Vladandrei23/STR/README.md

# STR
Smart Transport Robot

Link proiect 3D robot: https://cad.onshape.com/documents/0fa316edc2ccdc5bc86daad0/w/06460c8543eb481df427b248/e/61f51f2530e62bfbe1d57860

Link video demonstrativ: https://www.youtube.com/watch?v=n41Xtc9-K9c
