Vladandrei23/STR/poster STR.png

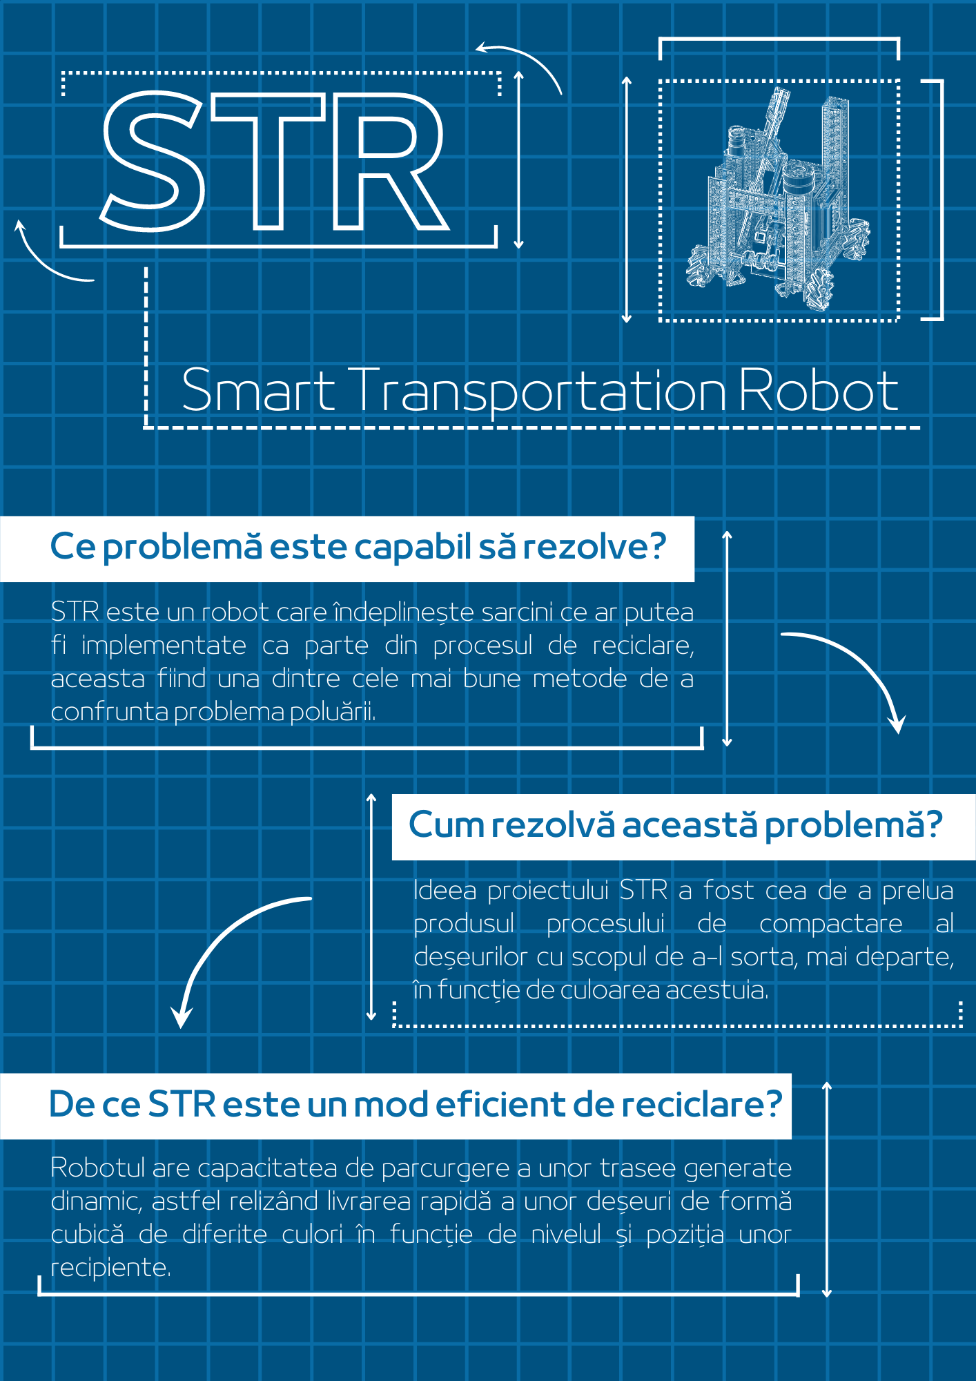
poster STR.png
