Vladandrei23/STR/piese printate 3d/brat.step

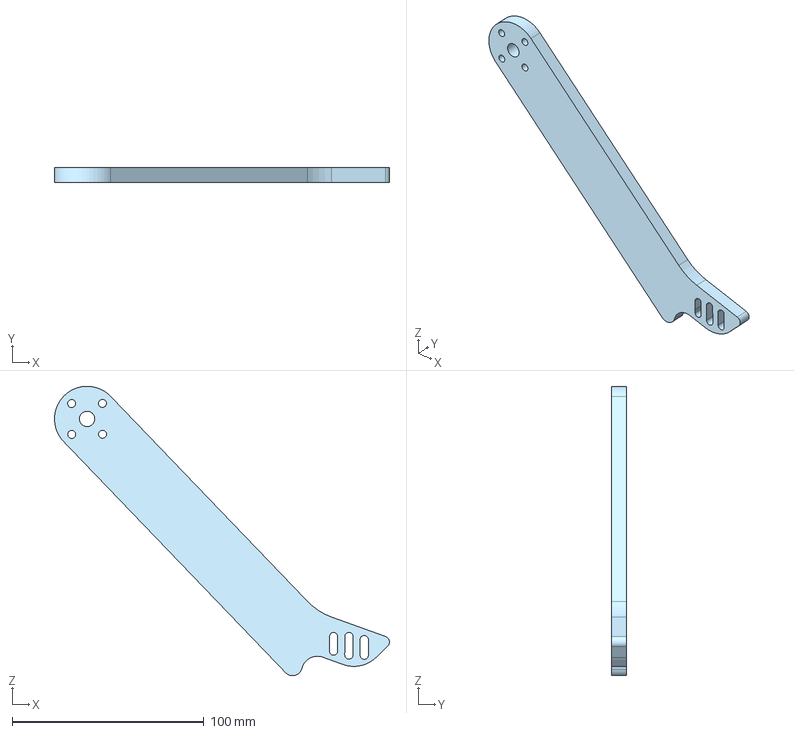
[picture p3: CAD file, 2022-07-07]
piese printate 3d/brat.step
174.6 x 8.00 x 150.8 mm
