Vladandrei23/STR/piese printate 3d/piese intake.step

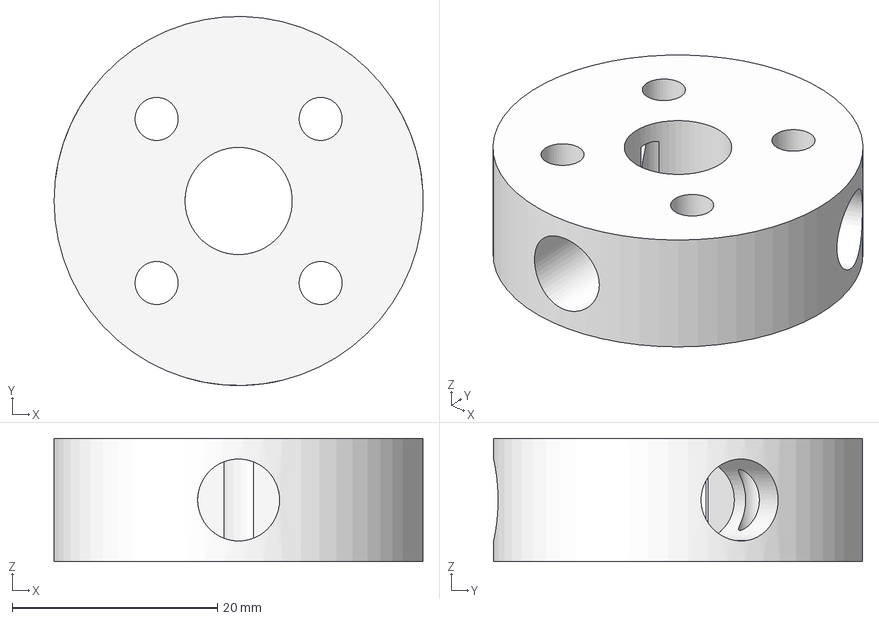
[picture p4: CAD file, 2022-07-07]
piese printate 3d/piese intake.step
36.0 x 36.0 x 12.0 mm
