Vladandrei23/STR/piese printate 3d/cutie.step

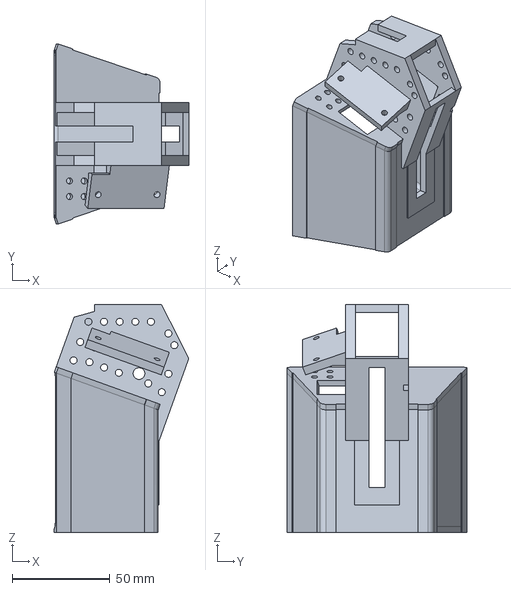
[picture p5: CAD file, 2022-07-07]
piese printate 3d/cutie.step
68.9 x 92.2 x 116.7 mm
